Dierumox/Two-axis-thrust-vectoring-Y6-drone/README.md

# Two axis thrust vectoring Y6 drone

This project focuses on the development of an experimental FPV Y6 drone with continuous two-axis thrust vectoring.
The platform uses a six-motor configuration (two motors for each propulsion unit; one rear propulsion unit and two front ones), where each propulsion unit can redirect its thrust through a dual-ring gimbal mechanism with full 360° rotational capability. This significantly increases maneuverability, attitude control authority, and fault tolerance compared with conventional multirotor designs.

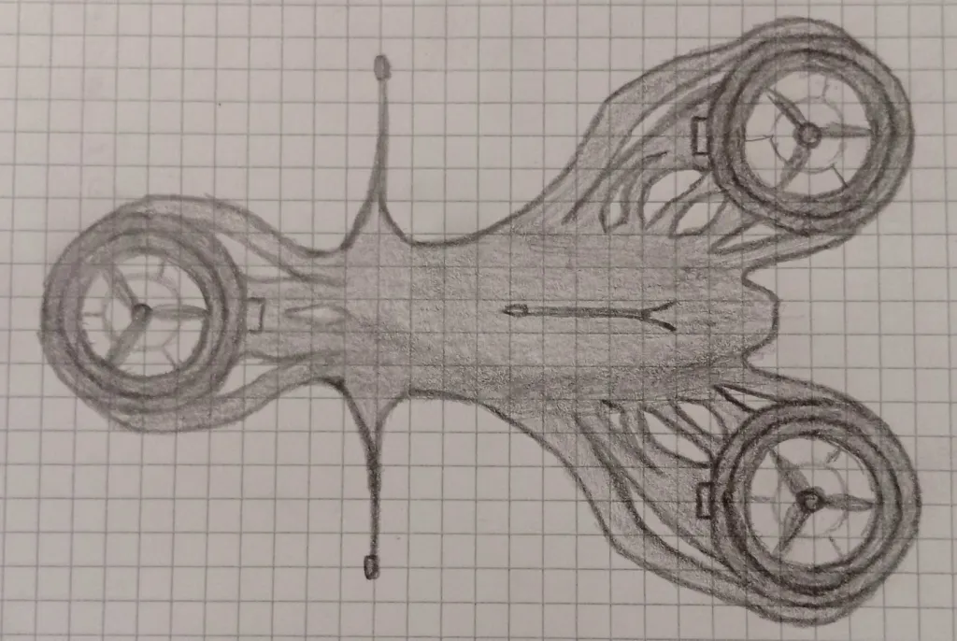
[picture p1: Media/tatvy6d_concept_sketch.png]

A concept sketch of the TATVY6D

The control system will be based on a Teensy 4.1 microcontroller programmed in C++, using ICM-42688-P inertial sensors and long-range LoRa communication. Power electronics will be integrated into the fixed main frame, and it will be transferred to moving assemblies through slip rings. Data will be transferred through a local ESP-NOW network formed by eleven ESP32-S3 SuperMini boards. Two of them will be connected to the Teensy 4.1: one dedicated to transmitting the packets containing the gimbal motor angle commands and thrust motor RPM setpoints calculated by the Teensy, and the other dedicated to receiving error reports and telemetry data from the remaining nine ESP32 nodes.
In addition to real-time FPV flight, the platform will include onboard video recording to MicroSD storage and an independent action camera.

A core objective of the project is to develop an aircraft capable of:

- Reconfiguring its geometry on the ground by relocating modules thanks to its modular design.

- Automatically detecting structural changes or deformations.

- Adapting its control system to the current geometry.

- Maintaining stability under partial motor or actuator failures.

- Serving as a test platform for advanced flight-control strategies.

As a future extension, in-flight geometry reconfiguration may also be explored.
A custom transmitter/controller specifically designed for the platform will also be developed.

## Project Status

Currently restructuring the repo.

## License

- **Software:** Licensed under [Apache 2.0](LICENSE-SOFTWARE).
- **Hardware:** Licensed under [CERN-OHL-W v2](LICENSE-HARDWARE).
