Dierumox/Two-axis-thrust-vectoring-Y6-drone/Gimbal_Design/Gimbal_Design - 1.0.md

Copyright 2026 Diego Rubio Mozo

This source describes the Gimbal Design 7.1 hardware and is licensed under the CERN Open Hardware Licence Version 2 - Weakly Reciprocal (CERN-OHL-W).

You may redistribute and modify this source under the terms of the CERN-OHL-W v2.0.

# Gimbal design - 1.0

The gimbals for the thrust vectoring will have two rotation axis, and they will be formed by two rings (one for each axis) that surround the propellers. The actuators for the mechanism will be 12V N20 High Torque motors, with a 210:1 gear ratio. This reductor provides (). () may seem too slow, but it means ()°/s. A correction of, for example, 10° will take just () seconds since it starts spinning until it reaches the final position (but it will take a little bit more, because we have to considerate the acceleration at the beninning and I will have to be careful with the innertia of the gears and will have to stop spinning just before it reaches the final position).
