Dierumox/Two-axis-thrust-vectoring-Y6-drone/Gimbal_Design/Gimbal_Design - 2.0.md

Copyright 2026 Diego Rubio Mozo

This source describes the Gimbal Design 7.1 hardware and is licensed under the CERN Open Hardware Licence Version 2 - Weakly Reciprocal (CERN-OHL-W).

You may redistribute and modify this source under the terms of the CERN-OHL-W v2.0.

# Gimbal design - 2.0
I realized that the gyroscopic precession force was at this point my biggest issue. Therefore, I decided to turn the Y3 into a Y6 configuration with counter-rotating propellers to cancel out the opposing forces.
