Dierumox/Two-axis-thrust-vectoring-Y6-drone/Gimbal_Design/Gimbal_Design - 3.0.md

Copyright 2026 Diego Rubio Mozo

This source describes the Gimbal Design 7.1 hardware and is licensed under the CERN Open Hardware Licence Version 2 - Weakly Reciprocal (CERN-OHL-W).

You may redistribute and modify this source under the terms of the CERN-OHL-W v2.0.

# Gimbal design - 3.0
The 2.0 version didn't solve how to power the electronics held on the gimbal rings, and most importantly, the main thrust motors. The 3.0 version introduces the data transmission slip rings for the first time, along with the brushless gimbal motors, the magnetic encoder to provide position feedback for each gimbal ring, and the CNC conductive bearings to carry the main power line.
