Dierumox/Two-axis-thrust-vectoring-Y6-drone/Gimbal_Design/Gimbal_Design - 4.0.md

Copyright 2026 Diego Rubio Mozo

This source describes the Gimbal Design 7.1 hardware and is licensed under the CERN Open Hardware Licence Version 2 - Weakly Reciprocal (CERN-OHL-W).

You may redistribute and modify this source under the terms of the CERN-OHL-W v2.0.

# Gimbal design - 4.0
The CNC conductive bearings, even with conductive lubricant, wouldn't have handled the current the system needed, so I considered using carbon brushed bearings. The design was soon discarded, because the carbon brushes would have generated conductive dust, fatal for the surrounding electronics.
