Dierumox/Two-axis-thrust-vectoring-Y6-drone/Gimbal_Design/Gimbal_Design - 5.0.md

Copyright 2026 Diego Rubio Mozo

This source describes the Gimbal Design 7.1 hardware and is licensed under the CERN Open Hardware Licence Version 2 - Weakly Reciprocal (CERN-OHL-W).

You may redistribute and modify this source under the terms of the CERN-OHL-W v2.0.

# Gimbal design - 5.0
This design discarded the carbon brushed conductive bearings, opting instead for standard bearings and slip rings for both data and main power line transmission. The data line, located on one side of the gimbal, uses the CAN bus protocol to eliminate the EMI. On the other side of the gimbal ring, a 2CH 40A slip ring handles the main power line. However, the main issue with this design is the heavy weight and large volume of this last slip ring.

System architecture

    BODY - AXIS 1
        BODY
            Teensy 4.1 - 1x
            SN65HVD230 CAN transceiver - 1x
            120 ohm resistor for the CAN bus echo in parallel on the CAN transceiver - 1x
            6S battery - 1x
            6S-5/12V converter for the motor driver - 1x
            DRVxxxx FOC motor driver with CAN bus - 1x
            GM3506 gimbal motor with belt drive reduction system - 1x
            30A 4CH Senring - () part - 1x
            6CH gimbal motor power supply and CAN bus slip ring - () part - 1x
            Bearing - () part - 2x
            AS5048A SPI module - 1x
        AXIS 1
            Diametric magnet - 1x
            30A 4CH Senring - () part - 1x
            6CH gimbal motor power supply and CAN bus slip ring - () part - 1x
            Bearing - () part - 2x
            Pulley for the GM3506 - 1x
    AXIS 1 - AXIS 2
        AXIS 1
            6S-5/12V converter for the motor driver - 1x
            DRVxxxx FOC motor driver with CAN bus - 1x
            GM3506 gimbal motor with belt drive reduction system - 1x
            30A 4CH Senring - () part - 1x
            4CH CAN bus slip ring - () part - 1x
            Bearing - () part - 2x
            AS5048A SPI module - 1x
        AXIS 2
            Diametric magnet - 1x
            30A 4CH Senring - () part - 1x
            4CH CAN bus slip ring - () part - 1x
            Bearing - () part - 2x
            Pulley for the GM3506 - 1x
            2004 1800KV 6S motor - 2x
            2-in-1 ESC with CAN bus - 1x
            120 ohm resistor for the CAN bus echo in parallel on the 2-in-1 ESC - 1x
            Motor holder structure - 1x
