Dierumox/Two-axis-thrust-vectoring-Y6-drone/Central_Controller/Mathematical_Foundation.md

This section explains how the system calculates gimbal servo angles and main motor thrust to produce the desired rotation and
translation of the drone.

First of all, these are simple 3D dynamics equations:



F_i is the thrust vector the motor i produces, and r_i is the position vector of the center motor i, being this point where
the vector F_i starts.

If we develop the previous equations:

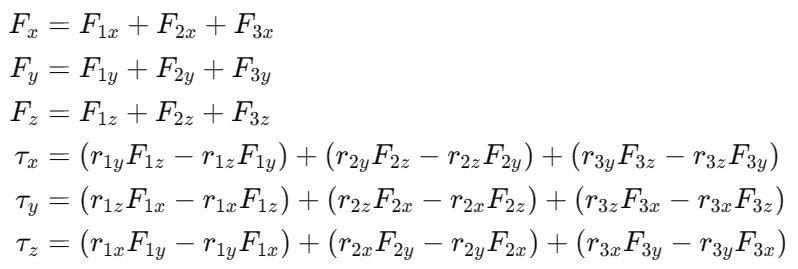
[picture p2: Media/developed6eq.png]


Those six equations form a system of equations of the drone dynamics, but we have to define clearly the unknowns and the 
determined values. The determined values are sent by the remote controller, and are the six expresions at the left side of the six previous equations:



And then we have nine unknowns:



Those are all the vector components of the three thrust vectors (three motors, three components each).
To manage all this we can create matrices. The matrix A will be the six equations, the matrix x will be the nine unknowns
and the matrix b will be the six determined values. The matrices are the following:

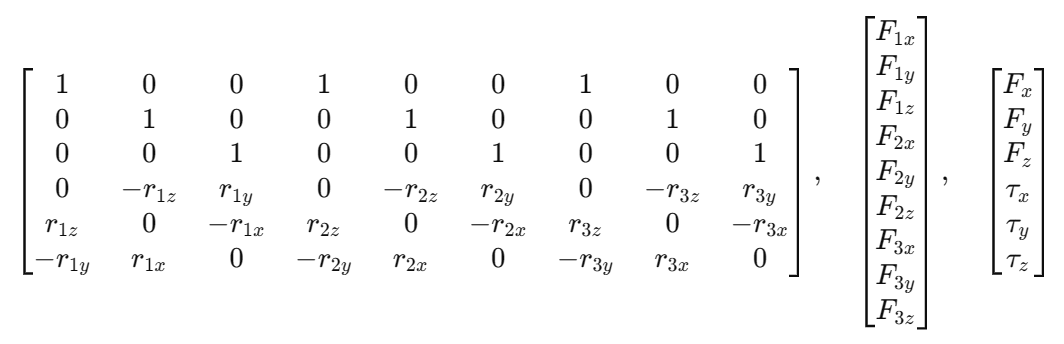
[picture p3: Media/3sepmatr.png]


They form this matricial system of equations:



That system is underdetermined, so we have to find the most efficient solution in the 3D solution space. We are looking for 
the minimum-norm solution, the most energy-efficient one. To find it, we resort to the Moore-Penrose pseudoinverse. Its 
formula for a system that has less lines than columns (6x9) is the following:



And the minimum-norm solution is:



If we calculate A·A^T we get a new 6x6 matrix, which we will call P. Then, we would have to calculate the inverse of P, but
it is a too long procedure thet we can avoid with other mathematical tool: Cholesky factorization. We create a lower 
triangular matrix that satisfies:



The formula for the diagonal of the L matrix is:

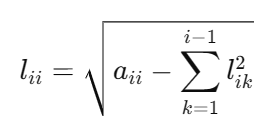
[picture p4: Media/Choldiag.png]


And the formula for the lower part of the matrix is:



That the matrices L and L^T are triangular matrices means that we can solve systems with them easily. The next step is to 
get those systems. This is the procedure:



We have to solve first Ly=b, and this is the formula (being L=l_ij):



Now that we have the matrix y, we solve the next system (L^T·u=y) with:



Then, with the matrix u, we can solve x=A^T·u, and we get the minimum-norm solution to Ax=b.
