Dierumox/Two-axis-thrust-vectoring-Y6-drone/(commit log)

2026-05-02 Rename Captura de pantalla 2026-05-02 122637.png to simple2eq.png
2026-05-02 Rename Captura de pantalla 2026-05-02 124506.png to 9unkn.png
2026-05-02 Rename Captura de pantalla 2026-05-02 130732.png to 6detval.png
2026-05-02 Rename Captura de pantalla 2026-05-02 151231.png to 3sepmatr.png
2026-05-02 Rename Captura de pantalla 2026-05-02 152823.png to matrsysteq.png
2026-05-02 Rename Captura de pantalla 2026-05-02 154314.png to MPpseu.png
2026-05-02 Rename Captura de pantalla 2026-05-02 154625.png to appliedMPpseu.png
2026-05-02 Rename Captura de pantalla 2026-05-02 160508.png to LLTP.png
2026-05-02 Rename Captura de pantalla 2026-05-02 161014.png to Choldiag.png
2026-05-02 Rename Captura de pantalla 2026-05-02 161059.png to Chollow.png
2026-05-02 Rename Captura de pantalla 2026-05-02 162806.png to Cholsystprocedure.png
2026-05-02 Rename Captura de pantalla 2026-05-02 163604.png to Lybformula.png
2026-05-02 Rename Captura de pantalla 2026-05-02 164521.png to LTuyformula.png
2026-05-14 Clarify 6S-5/12V converter description
2026-05-17 Enhance control system details in README
    Updated the control system description to include data transfer details and ESP32-C3 board integration.
2026-05-17 Update ESP32 model from C3 to S3 in README
    Updated the README to reflect changes in the ESP32 model used in the control system.
2026-05-17 Revise project status in README
    Updated project status to reflect current work on Gimbal Design 7.1, including CAD design and programming.
2026-05-26 Mathematical foundation cplusplus error correcion
    [FOC_algorithm.ino, Mathematical_foundation_cplusplus.ino]
2026-07-27 RC filters for the MCP33131 A_IN^+
